hallgchris/2048-hw/pcb/2048-hw.kicad_pcb

## KiCad design pcb/2048-hw.kicad_pcb (2021-09-24)

Schematic: 2048-hw.sch

Parts:
C1, C2, C3, C4, C5: 4u7; C_0603_1608Metric_Pad1.08x0.95mm_HandSolder
C6, C7, C10, C12, C13, C14, C15, C16, C17, C18, C19, C20, C21, C22, C23, C24, C25, C26, C27, C28, C29, C30: 100n; C_0603_1608Metric_Pad1.08x0.95mm_HandSolder
C8, C11: 1u; C_0603_1608Metric_Pad1.08x0.95mm_HandSolder
C9: 10n; C_0603_1608Metric_Pad1.08x0.95mm_HandSolder
D1: SMAJ5.0A; D_SMA_Handsoldering
D2: Charging; LED_0603_1608Metric_Pad1.05x0.95mm_HandSolder
D3: Done; LED_0603_1608Metric_Pad1.05x0.95mm_HandSolder
D4: 3V3; LED_0603_1608Metric_Pad1.05x0.95mm_HandSolder
D5: STATUS; LED_0603_1608Metric_Pad1.05x0.95mm_HandSolder
D6, D7, D8, D9, D10, D11, D12, D13, D14, D15, D16, D17, D18, D19, D20, D21: WS2812B; LED_WS2812B_PLCC4_5.0x5.0mm_P3.2mm_no1
D22: ds30308; D_SOD-123
H1, H2, H3, H4: MountingHole; MountingHole_3.2mm_M3
J1: UJC-HP-3-SMT-TR; CUI_UJC-HP-3-SMT-TR
J2: Battery; JST_PH_S2B-PH-K_1x02_P2.00mm_Horizontal
J3: SWD; PinHeader_1x06_P2.54mm_Horizontal
JP1: BOOT0; SolderJumper-2_P1.3mm_Open_RoundedPad1.0x1.5mm
L1: 39n; L_0603_1608Metric_Pad1.05x0.95mm_HandSolder
Q1: PMV27UPE; SOT-23
R1, R2, R6, R10, R18: 4k7; R_0603_1608Metric_Pad0.98x0.95mm_HandSolder
R3, R4, R5, R9, R11, R17, R19, R21, R22: 2k2; R_0603_1608Metric_Pad0.98x0.95mm_HandSolder
R7: 100k; R_0603_1608Metric_Pad0.98x0.95mm_HandSolder
R8, R23, R24: 10k; R_0603_1608Metric_Pad0.98x0.95mm_HandSolder
R13, R14, R15, R16: 22; R_0603_1608Metric_Pad0.98x0.95mm_HandSolder
R20: 330; R_0603_1608Metric_Pad0.98x0.95mm_HandSolder
SW1: SW_DPDT_x2; E_SWITCH_EG2208
SW2: PUSH_A; SW_PUSH_6mm_H5mm
SW3: PUSH_B; SW_PUSH_6mm_H5mm
TP1: GND; TestPoint_THTPad_D1.5mm_Drill0.7mm
TP2: 5V; TestPoint_THTPad_D1.5mm_Drill0.7mm
TP3: BAT+; TestPoint_THTPad_D1.5mm_Drill0.7mm
TP4: 3V3; TestPoint_THTPad_D1.5mm_Drill0.7mm
TP9: PUSH_A; TestPoint_THTPad_D1.5mm_Drill0.7mm
TP10: PUSH_B; TestPoint_THTPad_D1.5mm_Drill0.7mm
TP11: LED_DAT; TestPoint_THTPad_D1.5mm_Drill0.7mm
U1: STM32F303K8Tx; LQFP-32_7x7mm_P0.8mm
U2: MCP73831-2-OT; SOT-23-5
U3: AP2210N-3.3TRG1
U4: PSP_1000_JSTK; JOYSTICK-PSP1000
U5: LMV339; SOIC-14_3.9x8.7mm_P1.27mm
U6: AT24C08D-XHM-B; TSSOP-8_4.4x3mm_P0.65mm

Connections:
14_REF: R18.1, R19.2, U5.5 (+), U5.11 (+)
34_REF: R17.1, R18.2, U5.6 (-), U5.8 (-)
+3.3VA: C8.1, C9.1, L1.2, U1.5 (VDDA)
+3V3: C4.1, C5.1, C6.1, C7.1, C10.2, C12.2, J3.1, JP1.1 (A), L1.1, R9.2, R17.2, R23.1, R24.1, TP4.1, U1.1 (VDD), U1.17 (VDD), U3.2 (VOUT), U4.2 (VCC), U5.3 (V+), U6.8 (VCC)
+5V: C1.1, D1.1 (K), J1.A9 (V-BUS), J1.B9 (V-BUS), R4.1, SW1.5, TP2.1, U2.4 (VDD)
BAT_ADC: R6.1, R8.2, U1.6 (PA0)
BOOT0: JP1.2 (B), R10.2, U1.31 (BOOT0)
EEPROM_WP: U1.27 (PB4), U6.7 (WP)
GND: C1.2, C2.1, C3.2, C4.2, C5.2, C6.2, C7.2, C8.2, C9.2, C10.1, C11.2, C12.1, C13.2, C14.2, C15.2, C16.2, C17.2, C18.2, C19.2, C20.2, C21.2, C22.2, C23.2, C24.2, C25.2, C26.2, C27.2, C28.2, C29.2, C30.2, D1.2 (A), D4.1 (K), D6.3 (VSS), D7.3 (VSS), D8.3 (VSS), D9.3 (VSS), D10.3 (VSS), D11.3 (VSS), D12.3 (VSS), D13.3 (VSS), D14.3 (VSS), D15.3 (VSS), D16.3 (VSS), D17.3 (VSS), D18.3 (VSS), D19.3 (VSS), D20.3 (VSS), D21.3 (VSS), J1.A12 (GND), J1.B12 (GND), J1.S1 (SHIELD), J1.S2 (SHIELD), J1.S3 (SHIELD), J1.S4 (SHIELD), J2.1, J3.6, R1.1, R2.1, R3.2, R5.1, R7.2, R8.1, R10.1, R11.1, R19.1, SW2.1, SW3.1, TP1.1, U1.16 (VSS), U1.32 (VSS), U2.2 (VSS), U3.1 (GND), U4.4 (GND), U5.12 (V-), U6.3 (A2), U6.4 (GND)
I2C_SCL: R23.2, U1.29 (PB6), U6.6 (SCL)
I2C_SDA: R24.2, U1.30 (PB7), U6.5 (SDA)
JSTK_X: U4.1 (LEFT_RIGHT), U5.4 (-), U5.7 (+)
JSTK_Y: U4.3 (UP_DOWN), U5.9 (+), U5.10 (-)
LED_STATUS: D5.2 (A), U1.9 (PA3)
NRST: R15.2, U1.4 (NRST)
unnamed: D2.1 (K), D3.2 (A), U2.1 (STAT)
unnamed: D2.2 (A), R4.2
unnamed: D3.1 (K), R5.2
unnamed: D4.2 (A), R9.1
unnamed: D5.1 (K), R11.2
unnamed: D6.2 (DOUT), D7.4 (DIN)
unnamed: D6.4 (DIN), R20.2
unnamed: D7.2 (DOUT), D8.4 (DIN)
unnamed: D8.2 (DOUT), D9.4 (DIN)
unnamed: D10.2 (DOUT), D11.4 (DIN)
unnamed: D9.2 (DOUT), D10.4 (DIN)
unnamed: D11.2 (DOUT), D12.4 (DIN)
unnamed: D12.2 (DOUT), D13.4 (DIN)
unnamed: D13.2 (DOUT), D14.4 (DIN)
unnamed: D14.2 (DOUT), D15.4 (DIN)
unnamed: D15.2 (DOUT), D16.4 (DIN)
unnamed: D16.2 (DOUT), D17.4 (DIN)
unnamed: D17.2 (DOUT), D18.4 (DIN)
unnamed: D18.2 (DOUT), D19.4 (DIN)
unnamed: D19.2 (DOUT), D20.4 (DIN)
unnamed: D20.2 (DOUT), D21.4 (DIN)
unnamed: D22.2, Q1.1, R7.1, SW1.6
unnamed: J1.A5 (CC1), R1.2
unnamed: J1.B5 (CC2), R2.2
unnamed: J3.2, R13.1
unnamed: J3.3, R14.1
unnamed: J3.4, R15.1
unnamed: J3.5, R16.1
unnamed: Q1.3, SW1.3
unnamed: R3.1, U2.5 (PROG)
unnamed: R21.2, SW2.2
unnamed: R22.2, SW3.2
PUSH_A: C13.1, R21.1, TP9.1, U1.22 (PA12)
PUSH_B: C14.1, R22.1, TP10.1, U1.21 (PA11)
SPI1_MOSI: R20.1, TP11.1, U1.28 (PB5)
SWCLK: R13.2, U1.24 (PA14)
SWDIO: R14.2, U1.23 (PA13)
SWO: R16.2, U1.26 (PB3)
V_BAT: C3.1, C11.1, C15.1, C16.1, C17.1, C18.1, C19.1, C20.1, C21.1, C22.1, C23.1, C24.1, C25.1, C26.1, C27.1, C28.1, C29.1, C30.1, D6.1 (VDD), D7.1 (VDD), D8.1 (VDD), D9.1 (VDD), D10.1 (VDD), D11.1 (VDD), D12.1 (VDD), D13.1 (VDD), D14.1 (VDD), D15.1 (VDD), D16.1 (VDD), D17.1 (VDD), D18.1 (VDD), D19.1 (VDD), D20.1 (VDD), D21.1 (VDD), D22.1, Q1.2, R6.2, U3.3 (VIN)
V_BAT_IN: C2.2, J2.2, SW1.2, TP3.1, U2.3 (VBAT)
X_MAX: U1.14 (PB0), U5.2
X_MIN: U1.15 (PB1), U5.1
Y_MAX: U1.18 (PA8), U5.13
Y_MIN: U1.19 (PA9), U5.14

Notes on the sheet:
The stm32f303 has 40kOhm pull ups, forming an RC circuit with τ = 4ms.
Power supply
Microcontroller
Joystick
LED array
Pushbuttons
Mounting
Load sharing - Use 5V input if available instead of battery

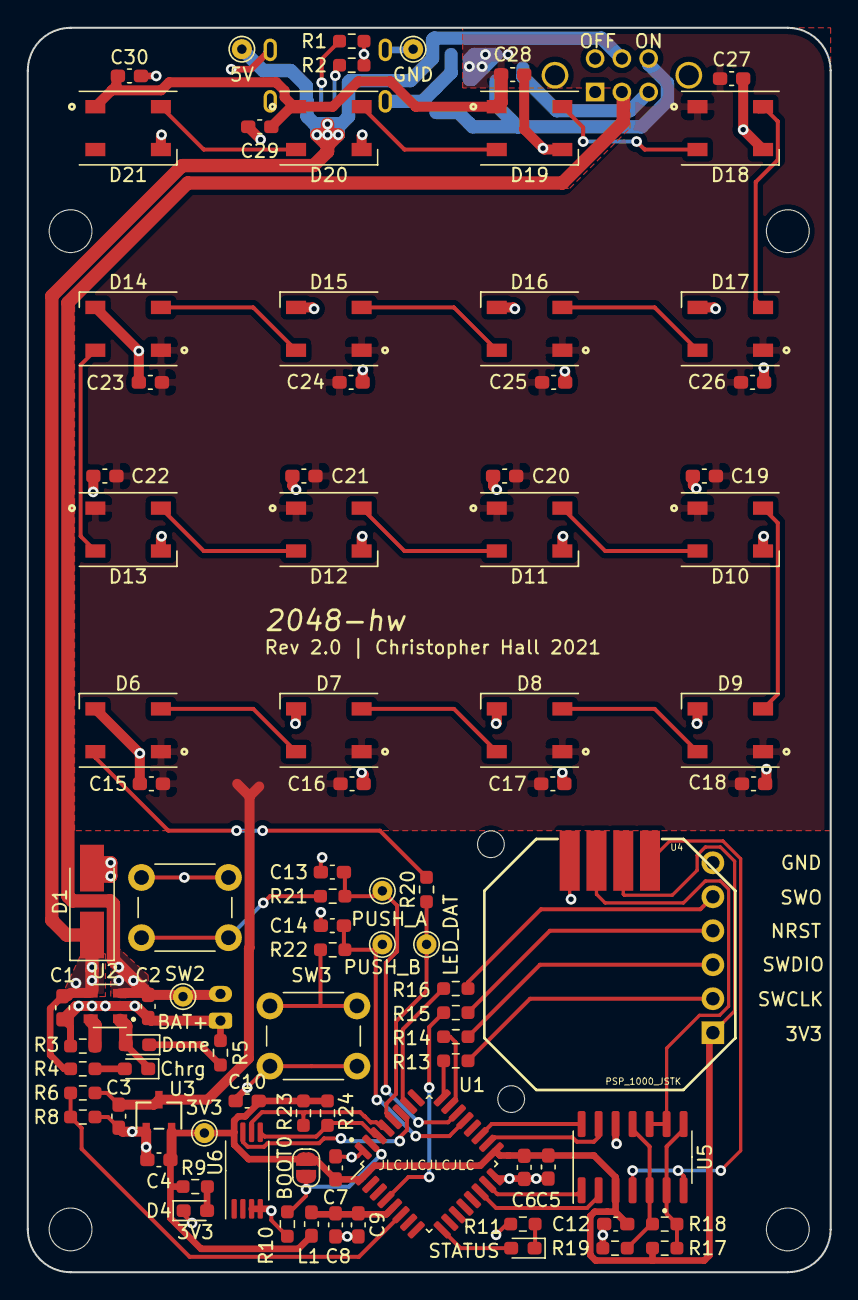
[picture p1: board 2048-hw.kicad_pcb from above]

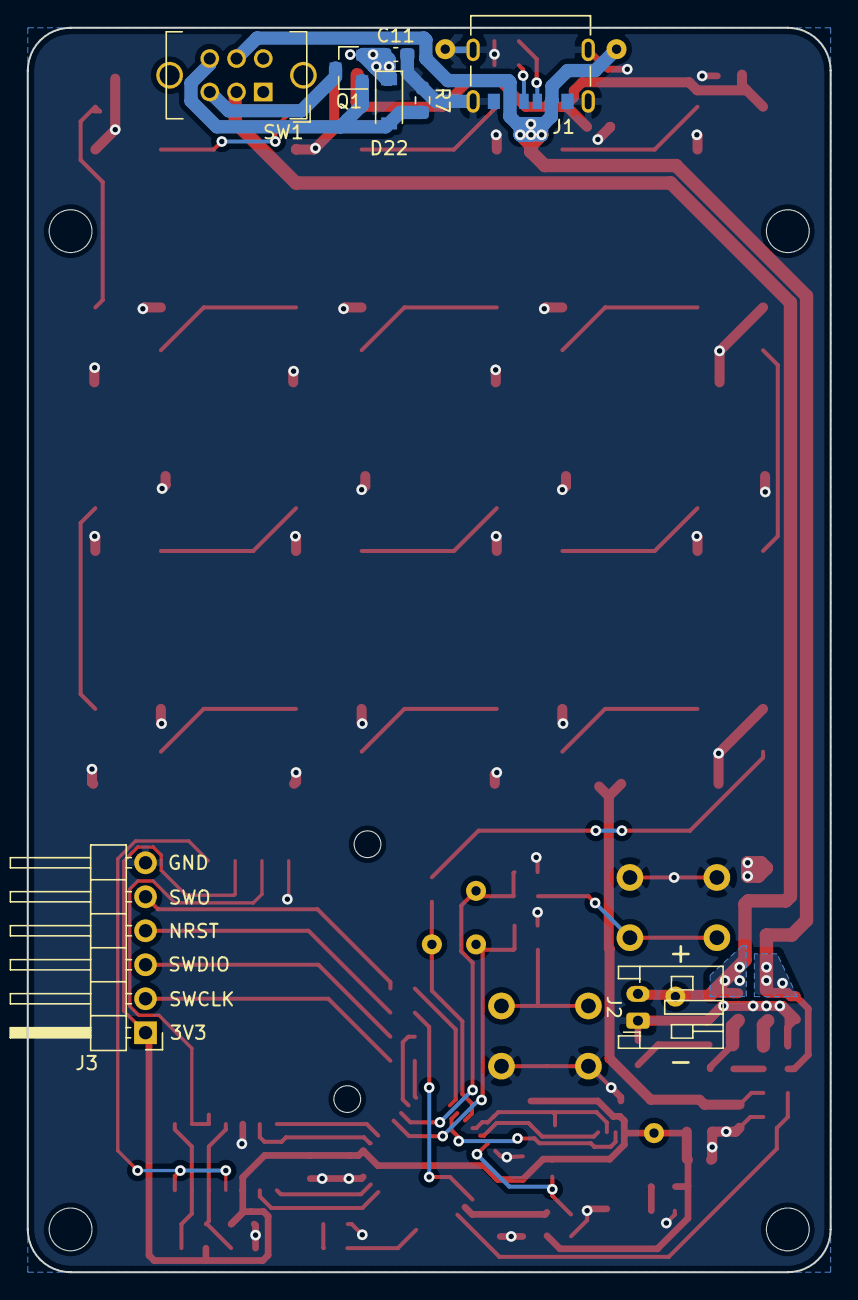
[picture p2: board 2048-hw.kicad_pcb from below]

Board: 2 copper layers, 60.0 x 93.0 mm, 101 parts (8 on the bottom side), 59 nets.
