hallgchris/2048-hw/pcb/cubemx/cubemx.ioc

Mcu.UserName=STM32F303K8Tx
PA9.GPIO_Label=Y_MIN
PA11.GPIO_Label=PUSH_B
PB0.GPIO_Label=X_MAX
PA12.GPIO_Label=PUSH_A
PA13.Signal=SYS_JTMS-SWDIO
PA12.Signal=GPIO_Input
PA8.GPIO_Label=Y_MAX
PA9.Signal=GPIO_Input
PB6.Signal=I2C1_SCL
PA5.Signal=SPI1_SCK
PB4.GPIO_Label=EEPROM_WP
PB1.GPIO_Label=X_MIN
PB7.Signal=I2C1_SDA
PA8.Signal=GPIO_Input
PA0.Signal=ADC1_IN1
PB3.Signal=SYS_JTDO-TRACESWO
PB5.Signal=SPI1_MOSI
PA6.Signal=SPI1_MISO
PB1.Signal=GPIO_Input
PA11.Signal=GPIO_Input
PA14.Signal=SYS_JTCK-SWCLK
PB0.Signal=GPIO_Input
PB4.Signal=GPIO_Output
PA3.GPIO_Label=LED_STATUS
PA3.Signal=GPIO_Output
