hallgchris/2048-hw/(commit log)

2020-12-31 Upload reference documtenation for stm32l4, mcp73831, usb C, battery
2020-12-31 Add initial charge controller and USB connection schematic
    [2048-hw.kicad_pcb, 2048-hw.sch]
2021-01-01 Add 3v3 regulator circuit
    [2048-hw.sch]
2021-01-01 Tidy up library symbols
    [2048-hw.sch]
2021-01-01 Add barebones circuitry for the stm32f303
    [2048-hw.sch]
2021-01-01 Add joystick circuitry
    [2048-hw.sch]
2021-01-01 Add battery ADC voltage divider
    [2048-hw.sch]
2021-01-01 Add ws2812b LEDs
    [2048-hw.sch]
2021-01-01 Add SWD header
    [2048-hw.sch]
2021-01-02 Add pushbuttons with debouncers
    [2048-hw.sch]
2021-01-02 Tidy up schematic
    [2048-hw.sch]
2021-01-03 Add testpoints
    [2048-hw.sch]
2021-01-03 Annotate all components
    [2048-hw.sch]
2021-01-03 Make ERC pass
    [2048-hw.sch]
2021-01-06 Assign footprints
    [2048-hw.sch]
2021-01-06 Combine libraries into single library
    [2048-hw.sch]
2021-01-07 Add high level board layout
    [2048-hw.kicad_pcb]
2021-01-07 Group components in layout
    [2048-hw.kicad_pcb, 2048-hw.sch]
2021-01-11 Update switches and battery
    [2048-hw.kicad_pcb, 2048-hw.sch]
2021-01-11 Initial layout of components
    [2048-hw.kicad_pcb, 2048-hw.sch]
2021-01-11 Make board square
    [2048-hw.kicad_pcb]
2021-01-11 Shink down PCB dimensions
    [2048-hw.kicad_pcb, 2048-hw.sch]
2021-01-15 Add text annotations to PCB
    [2048-hw.kicad_pcb]
2021-01-16 Add mounting holes
    [2048-hw.kicad_pcb, 2048-hw.sch]
2021-01-16 Round off board corners
    [2048-hw.kicad_pcb]
2021-01-16 Use shorter power switch
    [2048-hw.kicad_pcb, 2048-hw.sch]
2021-01-16 Tidy up silkscreen and traces
    [2048-hw.kicad_pcb, 2048-hw.sch]
2021-01-16 Reverse the backwards zener diode
    [2048-hw.kicad_pcb, 2048-hw.sch]
2021-01-23 Add kicad gitignore
2021-01-23 Update component values for BOM
    [2048-hw.kicad_pcb, 2048-hw.sch]
2021-01-24 fw: Create board struct
2021-01-26 fw: Implement blinky on a single WS2812 led
2021-01-27 fw: Generate random tiles on 2048 board
2021-01-30 fw: Add buttons to input demo
2021-09-24 pcb: Remove crystal
    [2048-hw.kicad_pcb, 2048-hw.sch]
2021-09-24 pcb: Add AT24C08D EEPROM to schematic
    [2048-hw.sch]
2021-09-24 pcb: Make routing changes to facilitate EEPROM
    [2048-hw.kicad_pcb, 2048-hw.sch]
2021-09-24 pcb: Make mounting holes M3/general tidy
    [2048-hw.kicad_pcb, 2048-hw.sch]
2021-09-24 pcb: Charge battery/power stuff independent of one another
    [2048-hw.kicad_pcb, 2048-hw.sch]
2021-09-24 pcb: Tidy up routing
    [2048-hw.kicad_pcb]
2021-09-24 pcb: Update version and changelog
    [2048-hw.sch]
2021-09-24 fw: Update stm32f3 hal to 0.7.0
2021-09-24 fw: Add RTIC gpio interrupt test
2021-09-24 fw: Use interrupts for movement inputs
2021-09-24 fw: Fix panic on large gaps between moves
    [main.rs]
2021-09-24 fw: Fix flicker caused by interrupts during LED write
    [main.rs]
2021-09-25 fw: Update pins for V2 pcb
2022-07-19 fw: Fix unintended reset due to delayed reset pin pull-up
    [main.rs]
